b-dmitry1/fpga286r2/doc/USB.md

# USB host

* Fully automatic full-speed USB host controller.
* Hardware CRC5 calculation.
* Configurable delays.
* Automatic ACK on DATA0 and DATA1.
* Automatic reset and re-init on STALL and on a connection loss.
* Automatic HID device initialization.
* Automatic periodic report requests.
* New RISC-V (rv32ima 50 MHz) core controls USB traffic.
* Composite devices support (Radio keyboard+mouse).
* Joysticks and mass storage devices will be recognized but requires firmware upgrade.
