b-dmitry1/fpga286r2/sch/README.md

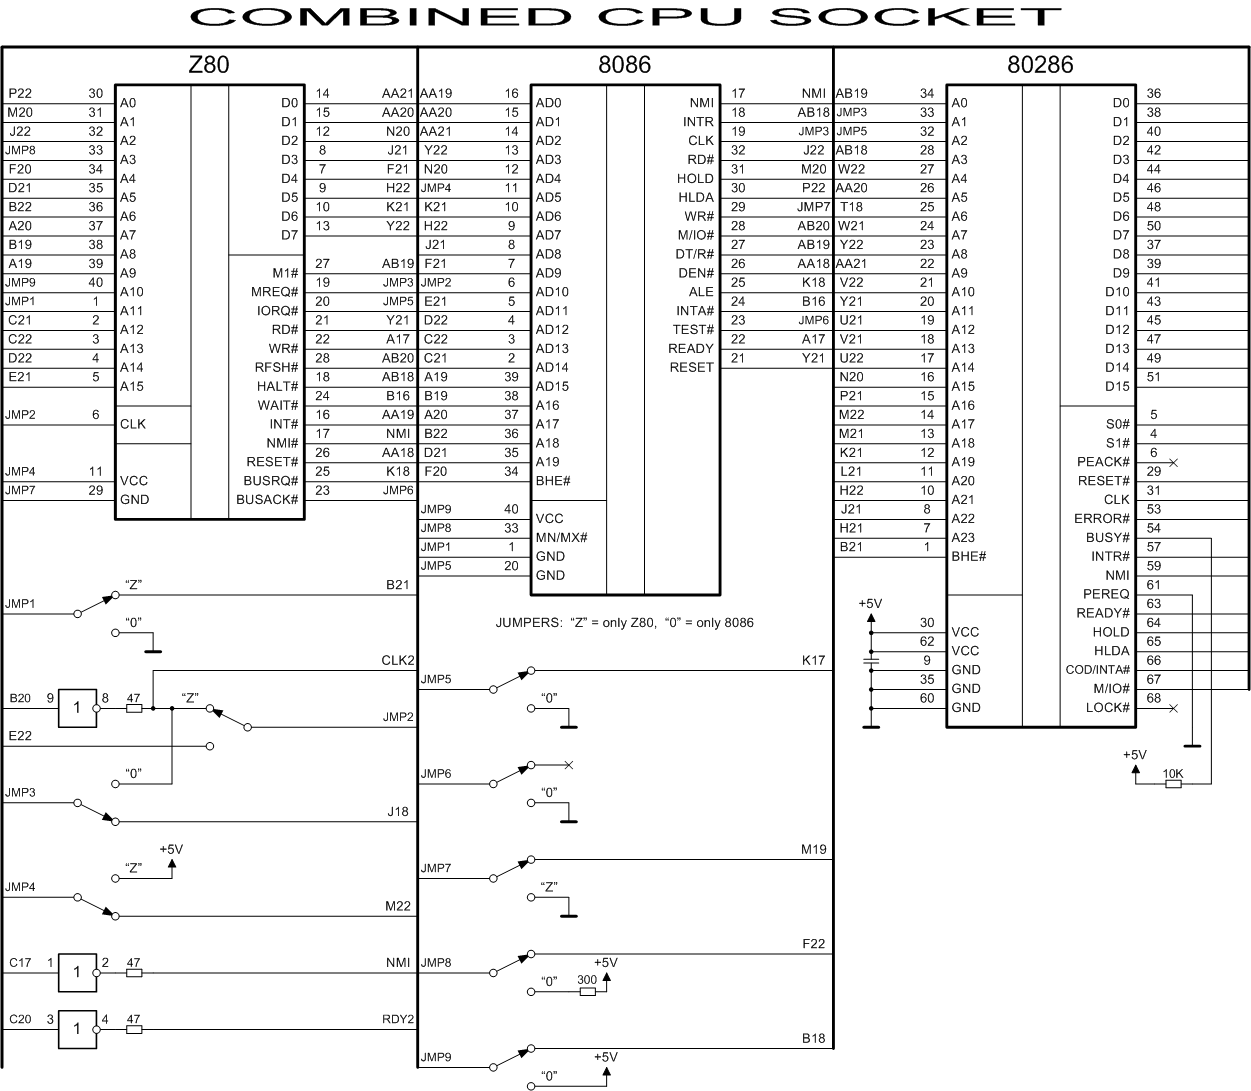
[picture p8: pictures/1.png]
cpu


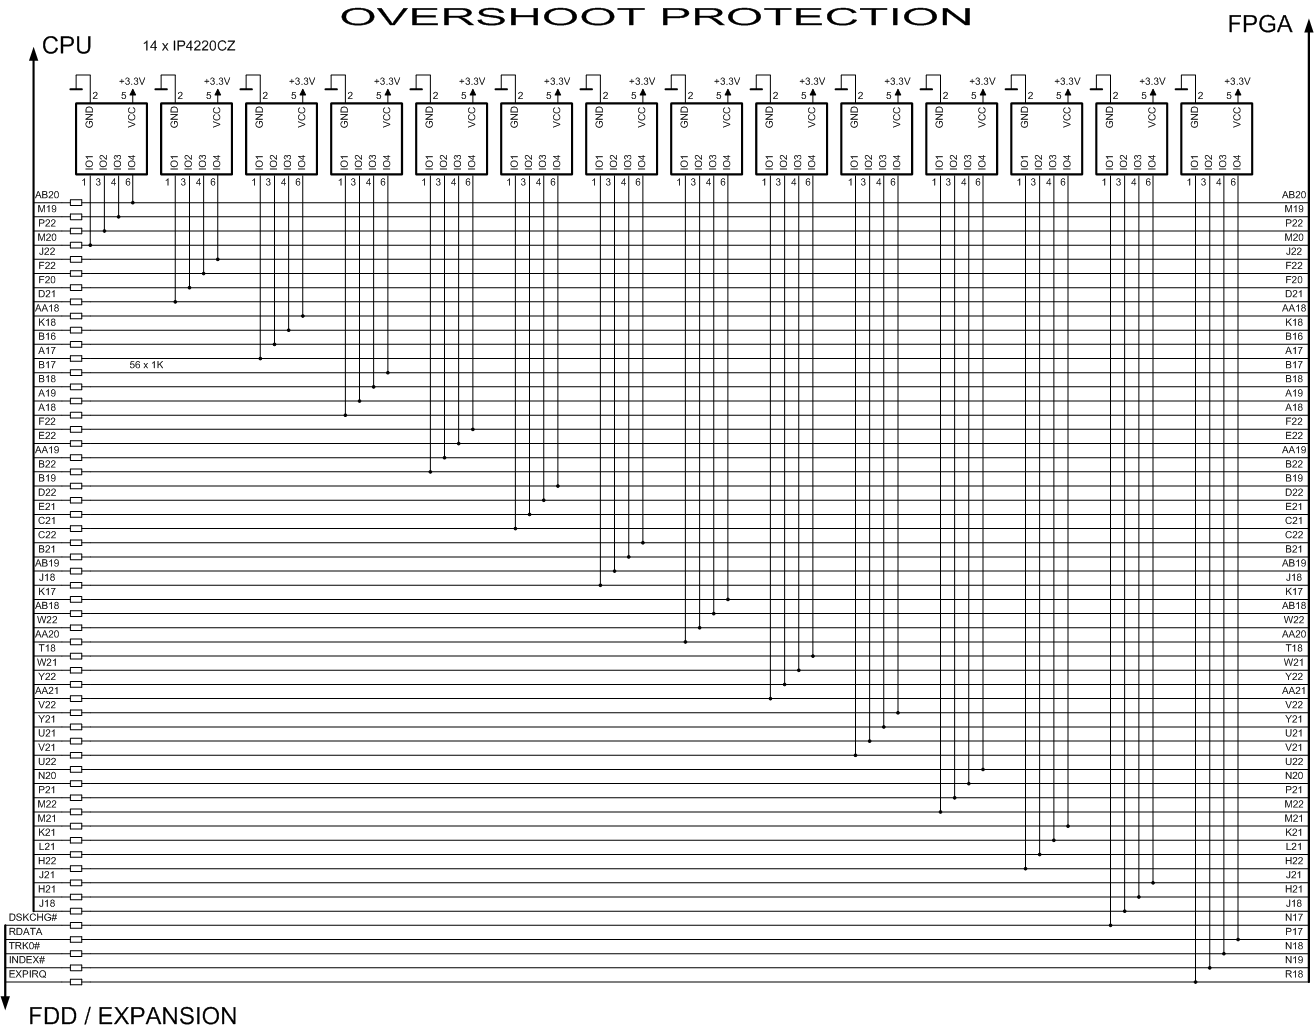
[picture p9: pictures/2.png]
overshoot


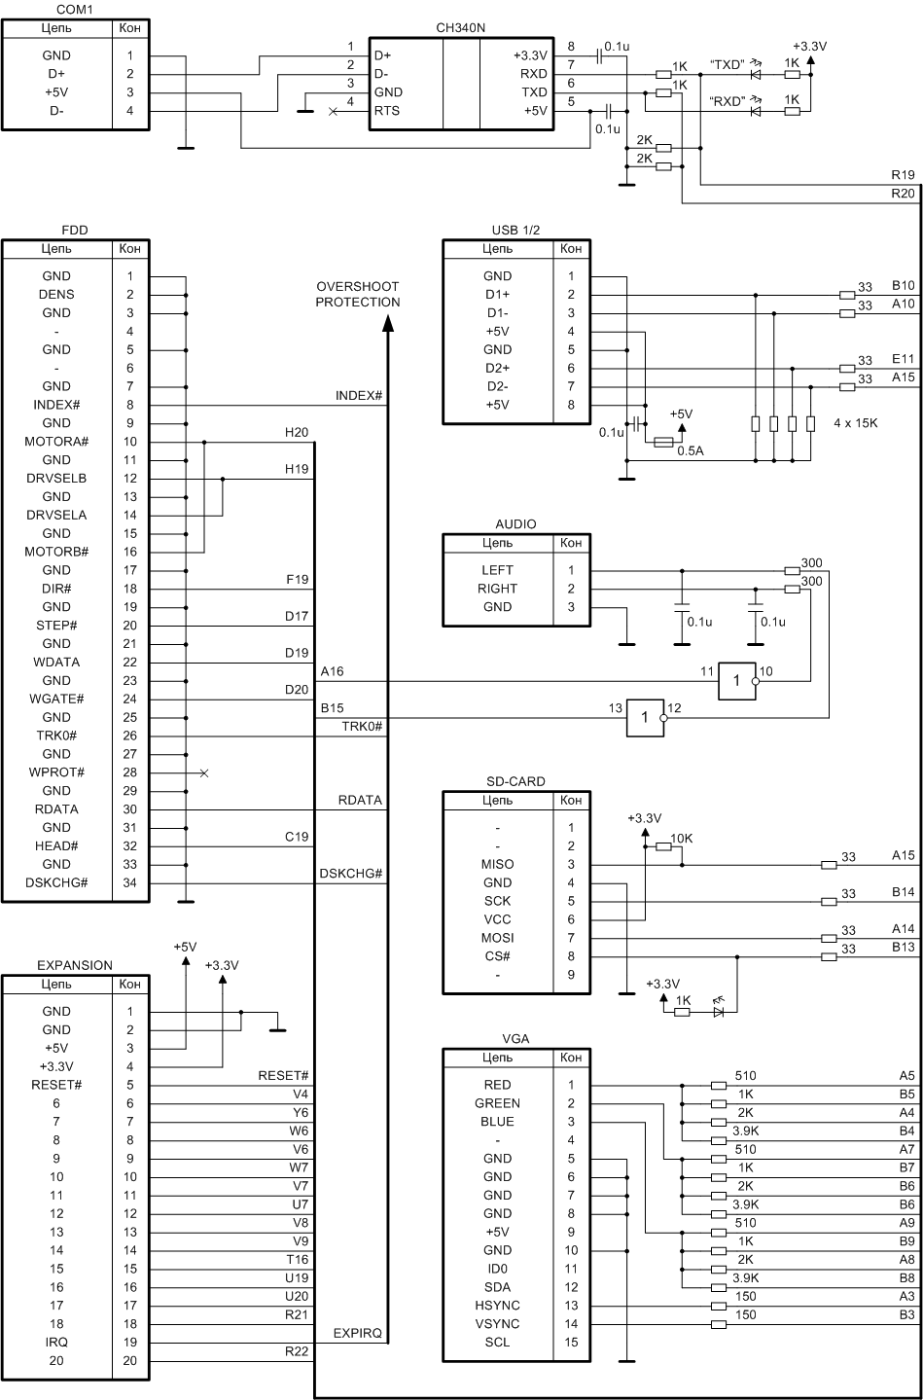
[picture p10: pictures/3.png]
interfaces


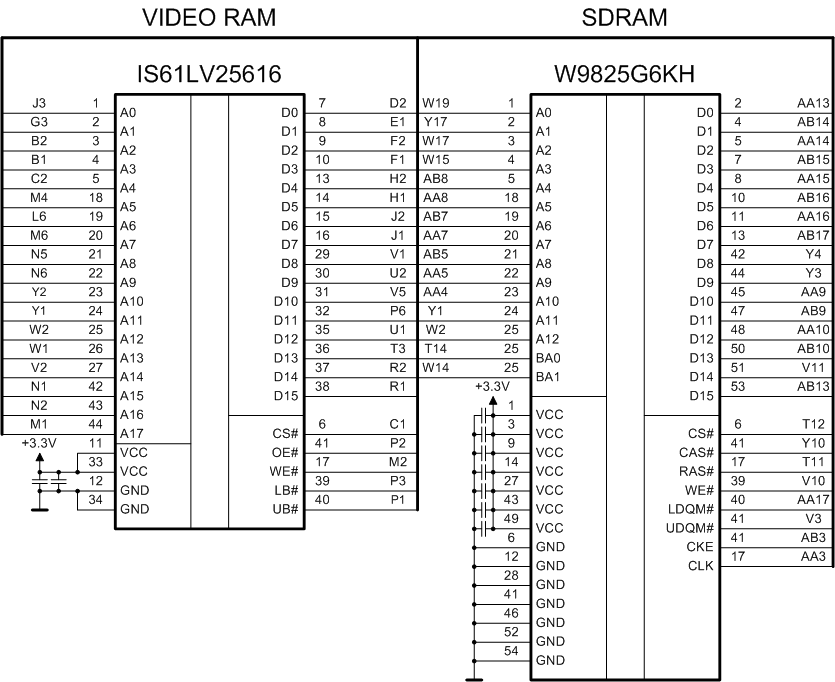
[picture p11: pictures/4.png]
ram
