b-dmitry1/fpga286r2/pictures/cpu.png

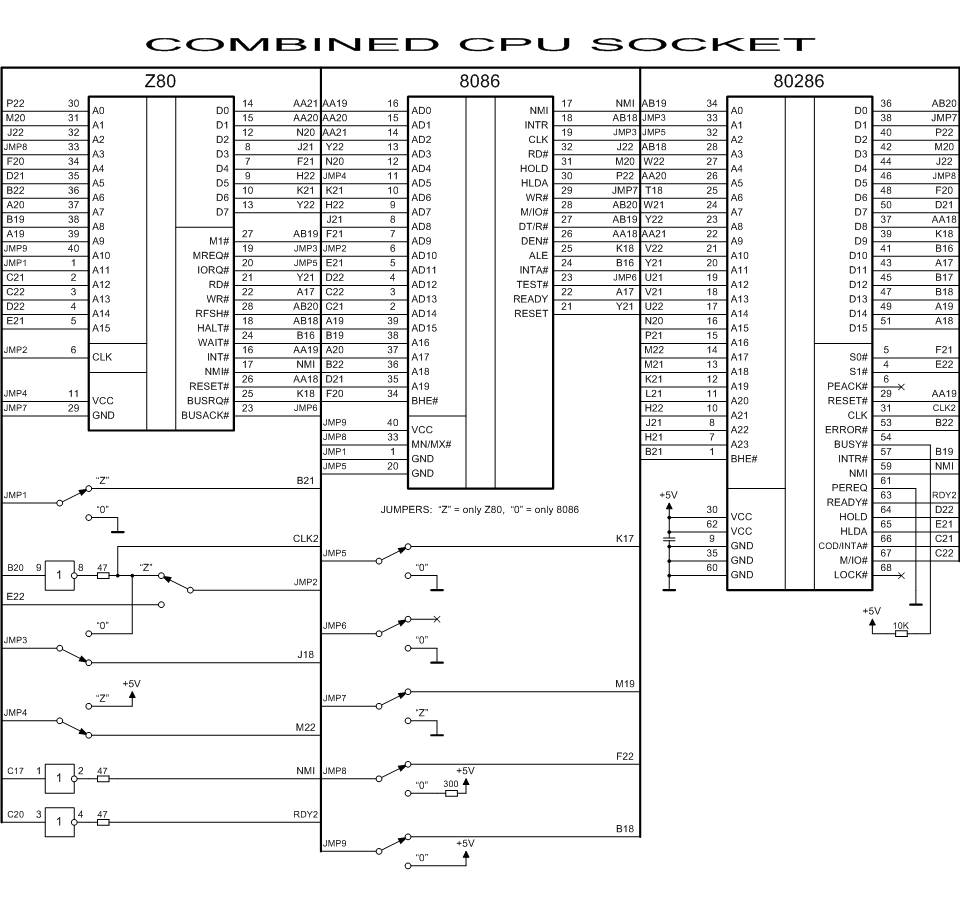
pictures/cpu.png
