b-dmitry1/fpga286r2/pictures/usb_osc.jpg

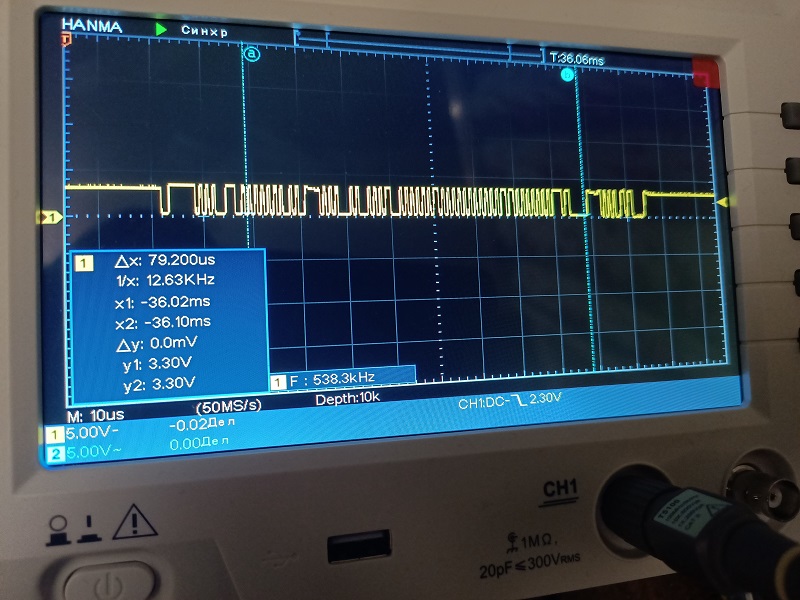
pictures/usb_osc.jpg
