b-dmitry1/fpga286r2/doc/Issues.md

# Known issues
* No return from protected mode due to absence of 70h port emulation.
* VGA virtual resolution (panning) calculation may be wrong for some games.
* VGA palette errors
* Very inaccurate YM3812 emulation
