b-dmitry1/fpga286r2/(list of files, drawings)

Other design files:
pcb/ep4f23_286.pcb
pcb/ep4f23_286_r2.lay6
pcb/ep4f23_286_v2.pcb
pcb/ep4f23_286_v2_m1.pcb
