b-dmitry1/fpga286r2/(commit log)

2023-01-22 Add simplified schematic and edit README
2023-03-14 doc: update PCB.md
2023-03-14 doc: update PCB description
2024-04-11 PCB: add CH340N, reroute 8086's MIO, DTR, INTA, RDY lines
    [E41521.lay6, ep4f23_286_r2.lay6, ep4f23_286_v2.pcb]
2024-08-18 Add CPU combined socket schematics
2024-08-20 Add schematics, fix some pin assignments
2024-08-28 PCB: fix CH340N, add J10, 512KB VRAM support, text labels
    [ep4f23_286_v2_m1.pcb]
2024-09-01 PCB: Add board assembly / FPGA pin test
2025-06-21 VGA: fix 256-color palette read error
    [VGA.v]
2025-06-21 risc-v: add min version, ym3812: stub with timers only
    This commit adds a "minimal" version of RISC-V core to help saving
    more LEs and slightly reduce compile time.
    It also adds YM3812 (AdLib sound card) stub with timers only. However,
    the IC is successfully detected by some games, and if you connect
    3.5 mm speakers you will hear ticks (like percussion) when game will
    try to play music.
